Darkzveller/ProgrammeGyropodeV2/Kicad Defi/LibMiniL298N/3D/DC Motor Driver.jpg

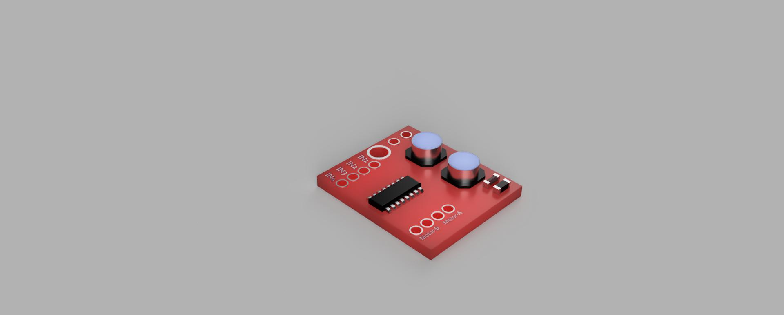
Kicad Defi/LibMiniL298N/3D/DC Motor Driver.jpg
