Darkzveller/ProgrammeGyropodeV2/Kicad Defi/LibGamelGe2_v6/3D/C_Rect_L4.0mm_W2.5mm_P2.50mm.STEP

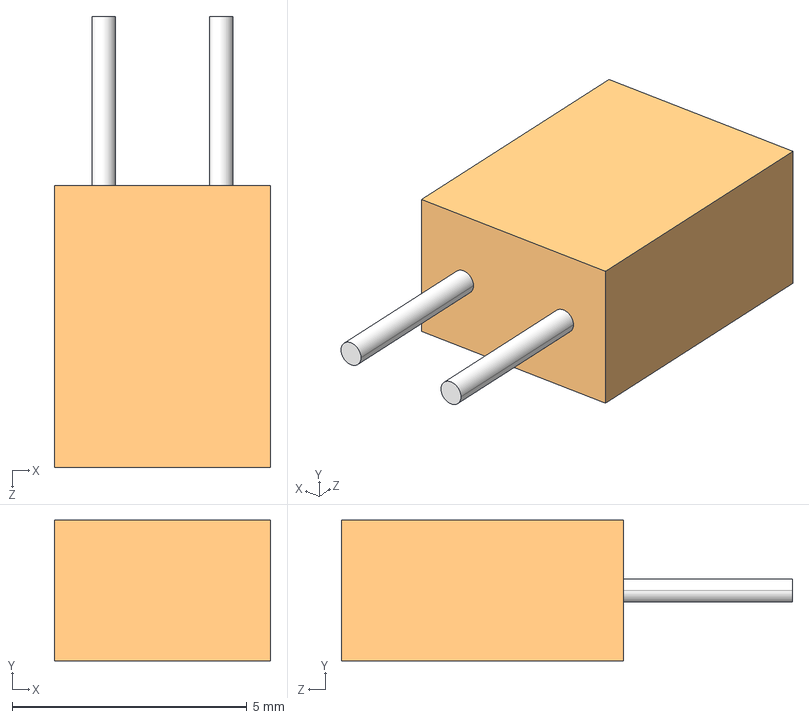
[picture p24: CAD file, 2024-11-21]
Kicad Defi/LibGamelGe2_v6/3D/C_Rect_L4.0mm_W2.5mm_P2.50mm.STEP
4.60 x 3.00 x 9.60 mm
