Darkzveller/ProgrammeGyropodeV2/Kicad Defi/LibMecatro/mecatro.models/L 1415465C.STEP

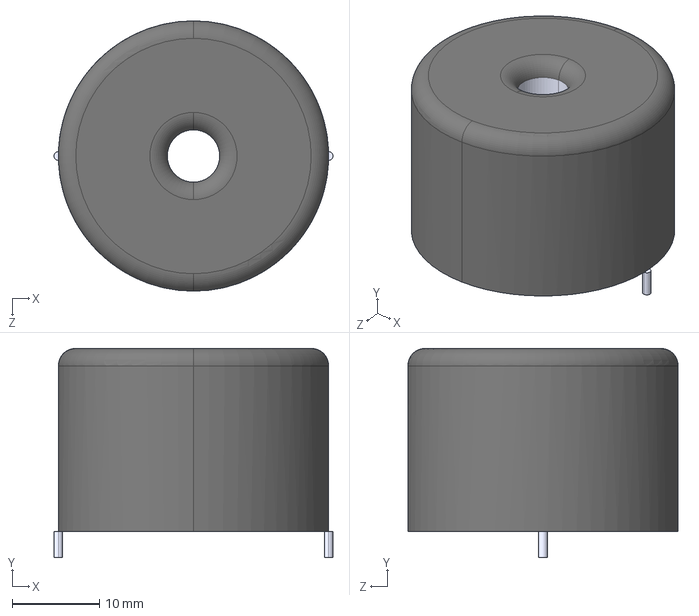
[picture p25: CAD file, 2024-11-21]
Kicad Defi/LibMecatro/mecatro.models/L 1415465C.STEP
32.0 x 24.0 x 31.0 mm
