Darkzveller/ProgrammeGyropodeV2/Kicad Defi/LibMiniL298N/3D/L298Mini.STEP

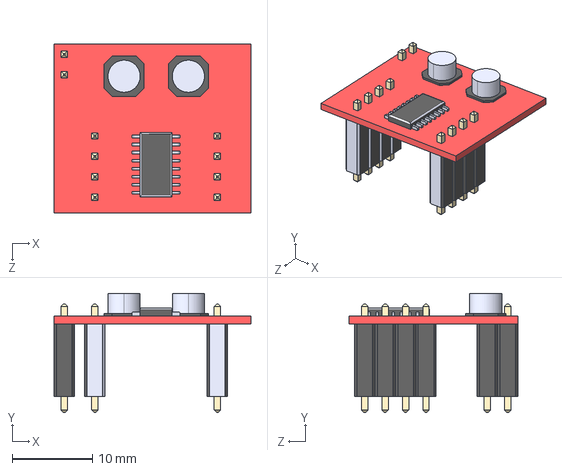
[picture p26: CAD file, 2024-11-21]
Kicad Defi/LibMiniL298N/3D/L298Mini.STEP
24.5 x 14.8 x 21.0 mm
