Darkzveller/ProgrammeGyropodeV2/Kicad Defi/LibRelais/LibRelais.3D/HF3FA.STEP

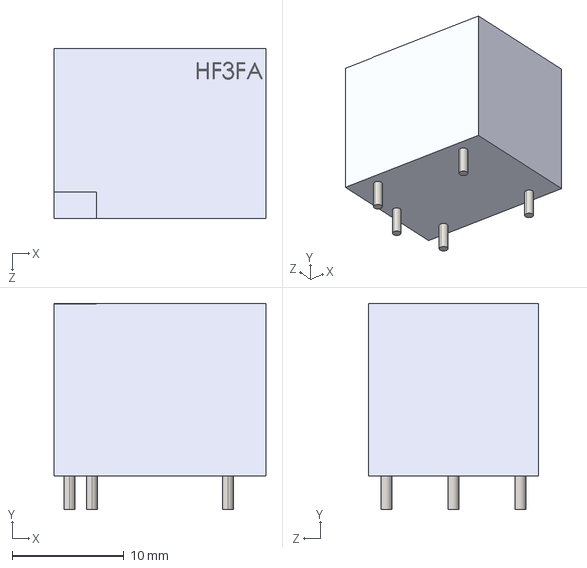
[picture p27: CAD file, 2024-11-21]
Kicad Defi/LibRelais/LibRelais.3D/HF3FA.STEP
19.0 x 18.5 x 15.2 mm
