Darkzveller/ProgrammeGyropodeV2/Kicad Defi/LibGamelGe2_v6/3D/autocom5.STEP

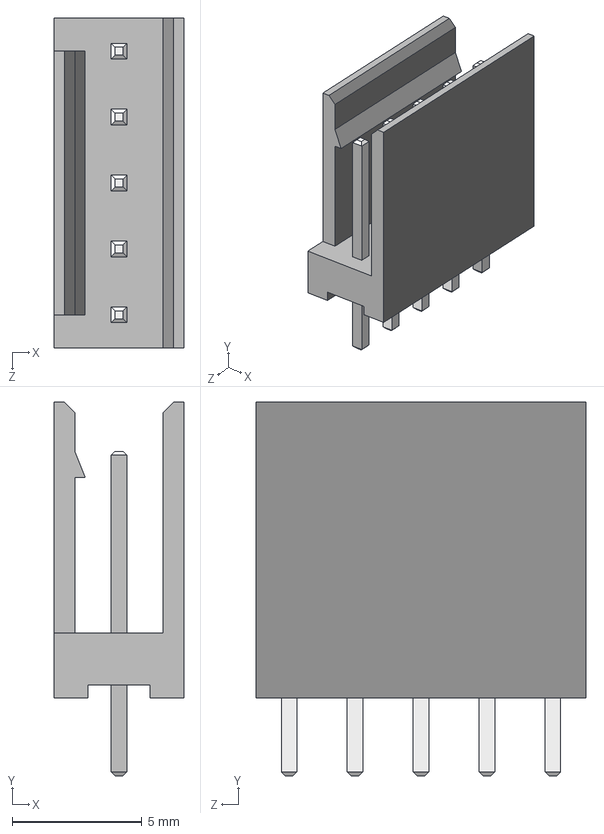
[picture p28: CAD file, 2024-11-21]
Kicad Defi/LibGamelGe2_v6/3D/autocom5.STEP
5.00 x 14.4 x 12.7 mm
