Darkzveller/ProgrammeGyropodeV2/Kicad Defi/LibMecatro/mecatro.models/MoteurGB37.STEP

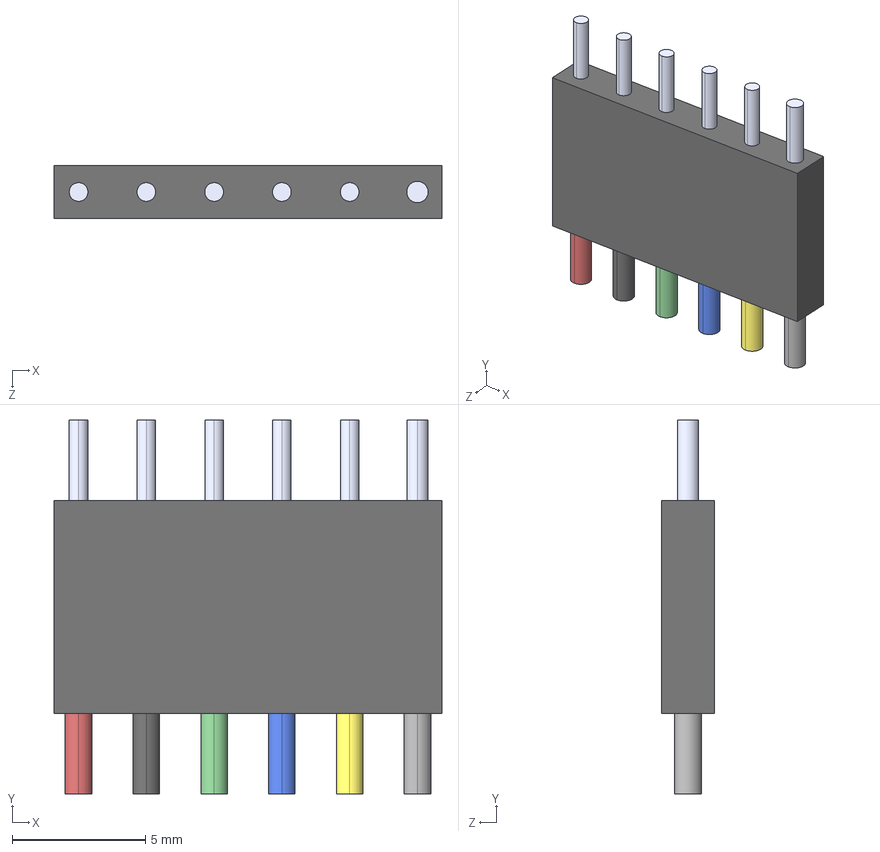
[picture p29: CAD file, 2024-11-21]
Kicad Defi/LibMecatro/mecatro.models/MoteurGB37.STEP
14.5 x 14.0 x 2.00 mm
