Darkzveller/ProgrammeGyropodeV2/Kicad Defi/LibMiniL298N/3D/DC Motor Driver .step

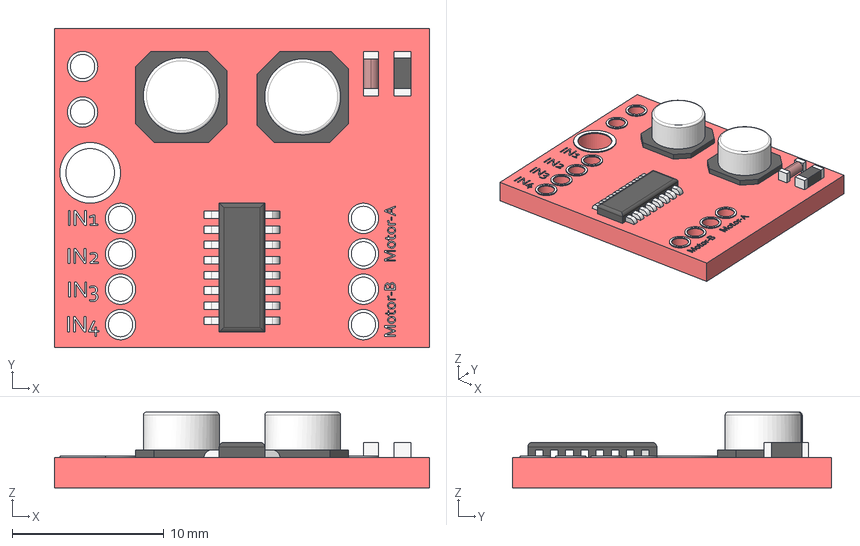
[picture p30: CAD file, 2024-11-21]
Kicad Defi/LibMiniL298N/3D/DC Motor Driver .step
24.7 x 21.0 x 5.00 mm
