Darkzveller/ProgrammeGyropodeV2/Kicad Defi/LibGamelGe2_v6/3D/C_Rect_L28.0mm_W8.0mm_P22.50mm.STEP

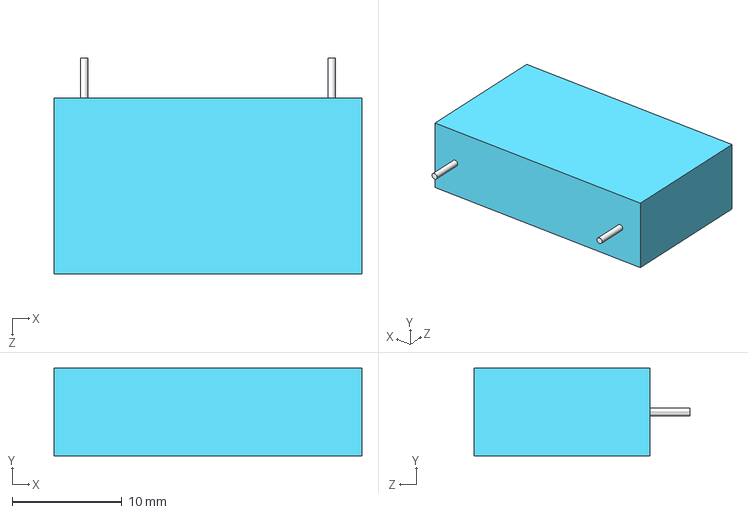
[picture p31: CAD file, 2024-11-21]
Kicad Defi/LibGamelGe2_v6/3D/C_Rect_L28.0mm_W8.0mm_P22.50mm.STEP
28.0 x 8.00 x 19.6 mm
