Darkzveller/ProgrammeGyropodeV2/Kicad Defi/LibMecatro/mecatro.models/DIP8-DEFAULT.STEP

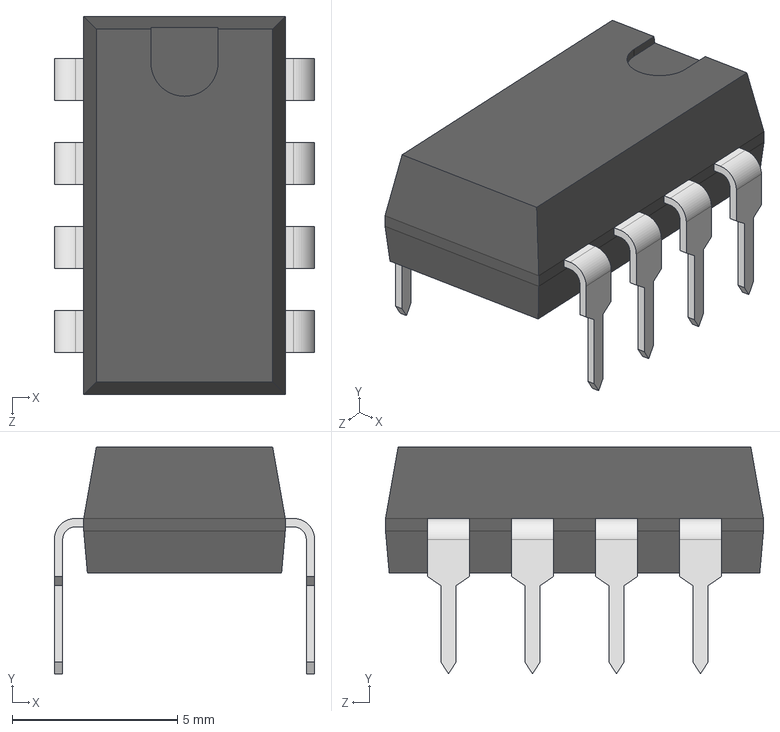
[picture p32: CAD file, 2024-11-21]
Kicad Defi/LibMecatro/mecatro.models/DIP8-DEFAULT.STEP
7.87 x 6.86 x 11.4 mm
