Darkzveller/ProgrammeGyropodeV2/Kicad Defi/LibGamelGe2_v6/3D/LED3mm_green.STEP

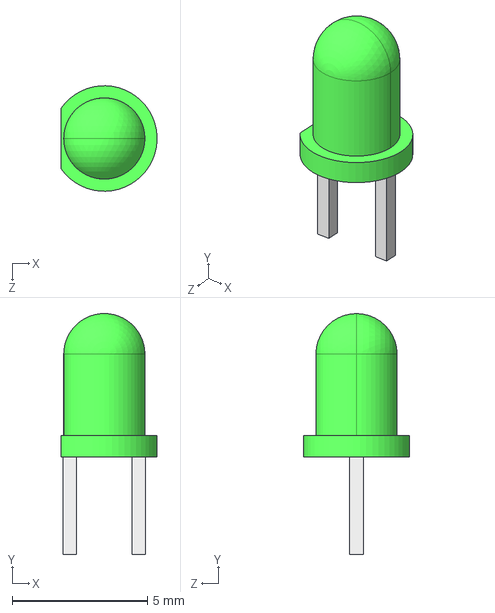
[picture p33: CAD file, 2024-11-21]
Kicad Defi/LibGamelGe2_v6/3D/LED3mm_green.STEP
3.55 x 8.90 x 3.90 mm
