Darkzveller/ProgrammeGyropodeV2/Kicad Defi/LibMecatro/mecatro.models/TO220-7-1.STEP

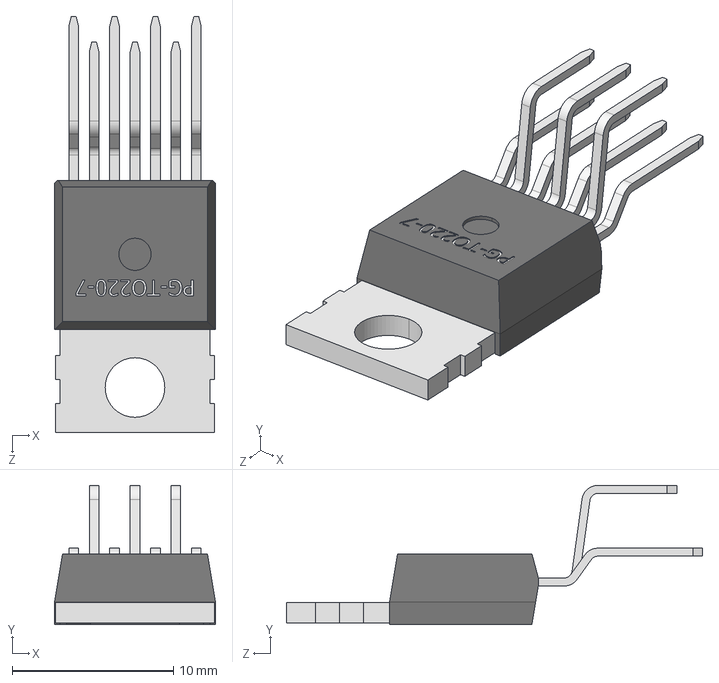
[picture p34: CAD file, 2024-11-21]
Kicad Defi/LibMecatro/mecatro.models/TO220-7-1.STEP
10.0 x 8.65 x 25.9 mm
