Darkzveller/ProgrammeGyropodeV2/Kicad Defi/LibGamelGe2_v6/3D/SW_push_5mm_blue.STEP

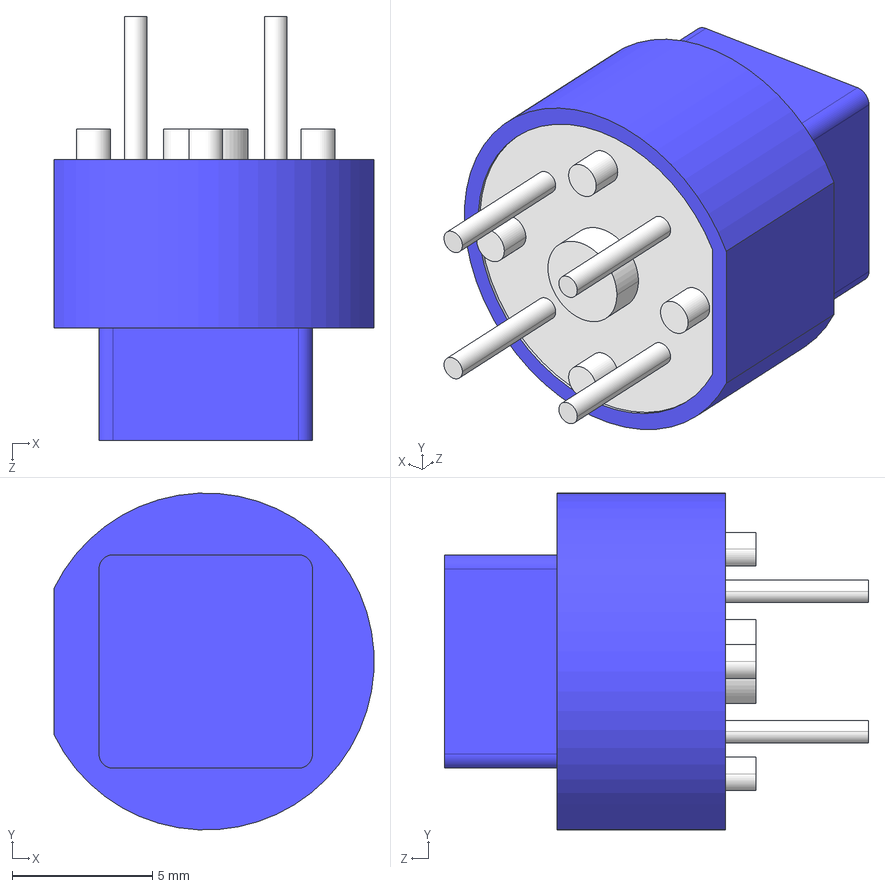
[picture p35: CAD file, 2024-11-21]
Kicad Defi/LibGamelGe2_v6/3D/SW_push_5mm_blue.STEP
11.4 x 12.0 x 15.1 mm
