Darkzveller/ProgrammeGyropodeV2/Kicad Defi/LibMecatro/mecatro.models/HC-05.STEP

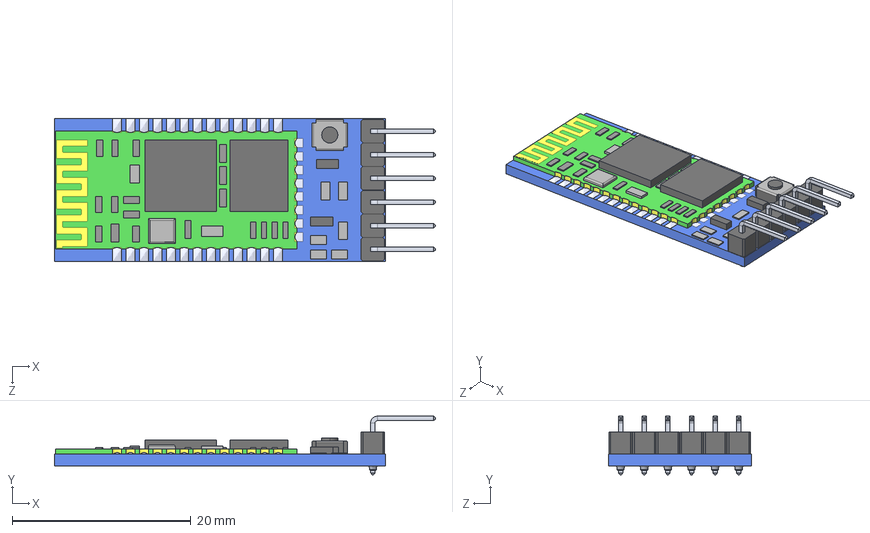
[picture p36: CAD file, 2024-11-21]
Kicad Defi/LibMecatro/mecatro.models/HC-05.STEP
42.6 x 6.55 x 16.0 mm
