Darkzveller/ProgrammeGyropodeV2/Kicad Defi/LibGamelGe2_v6/3D/HE10_2x10.STEP

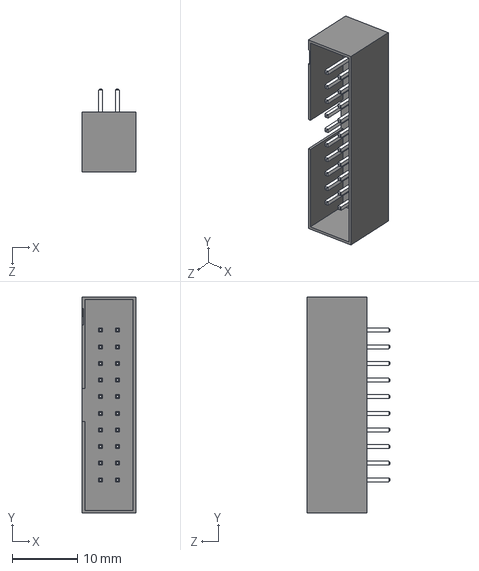
[picture p37: CAD file, 2024-11-21]
Kicad Defi/LibGamelGe2_v6/3D/HE10_2x10.STEP
8.20 x 33.0 x 12.7 mm
