Darkzveller/ProgrammeGyropodeV2/Kicad Defi/LibMecatro/mecatro.models/mpu6050schem.stp

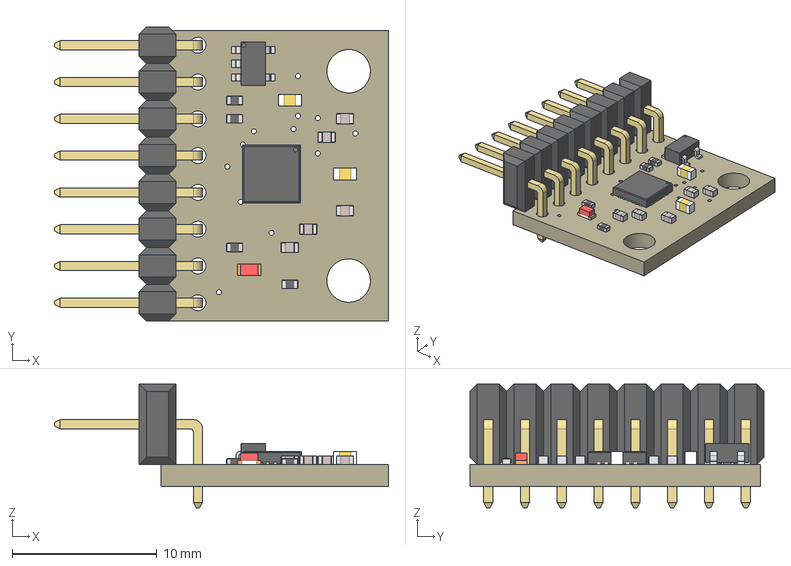
[picture p38: CAD file, 2024-11-21]
Kicad Defi/LibMecatro/mecatro.models/mpu6050schem.stp
23.1 x 20.3 x 8.56 mm
Board
SOT95P295X145-5N
QFN50P395X395X90-25T265X255N
CHIP-LED0603
HDRRA8W64P254_1X8_2032X254X556B
C0402 x 5
C0603 x 2
R0402 x 4
