Darkzveller/ProgrammeGyropodeV2/Kicad Defi/LibGamelGe2_v6/3D/C_Rect_L19.0mm_W5.0mm_P15.00mm.STEP

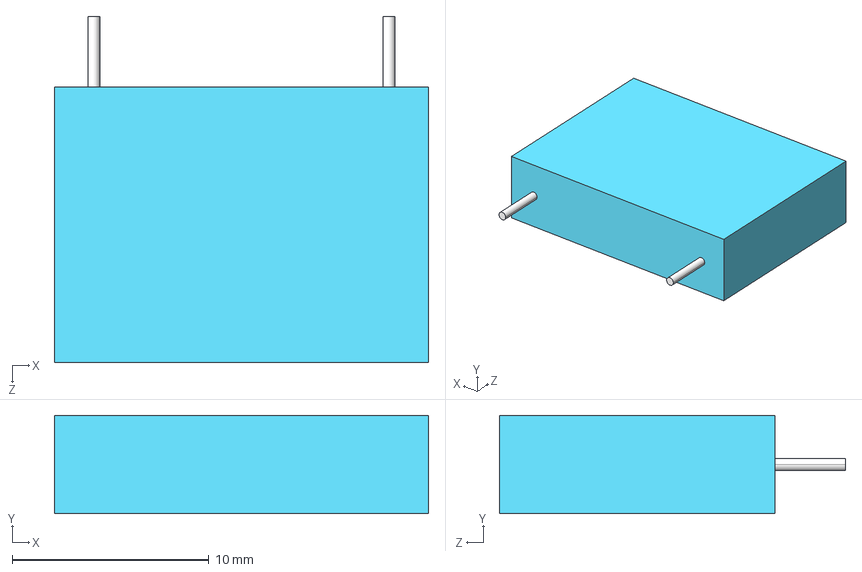
[picture p39: CAD file, 2024-11-21]
Kicad Defi/LibGamelGe2_v6/3D/C_Rect_L19.0mm_W5.0mm_P15.00mm.STEP
19.0 x 5.00 x 17.6 mm
