Darkzveller/ProgrammeGyropodeV2/Kicad Defi/LibMecatro/mecatro.models/esp32-DEV.STEP

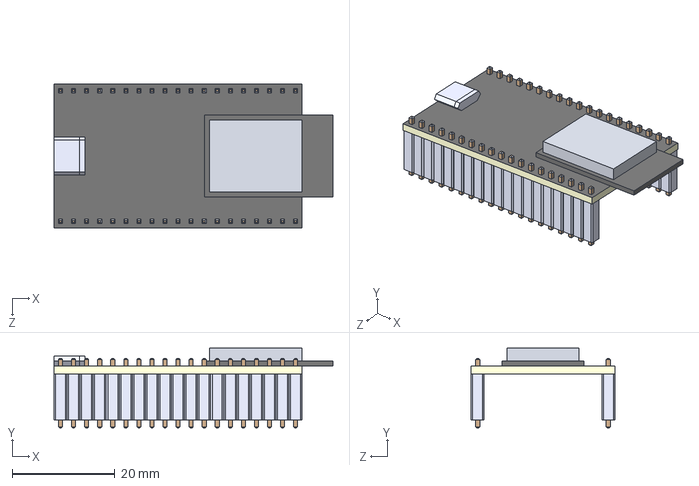
[picture p40: CAD file, 2024-11-21]
Kicad Defi/LibMecatro/mecatro.models/esp32-DEV.STEP
54.3 x 15.5 x 27.9 mm
