Darkzveller/ProgrammeGyropodeV2/Kicad Defi/LibGamelGe2_v6/3D/cny70.STEP

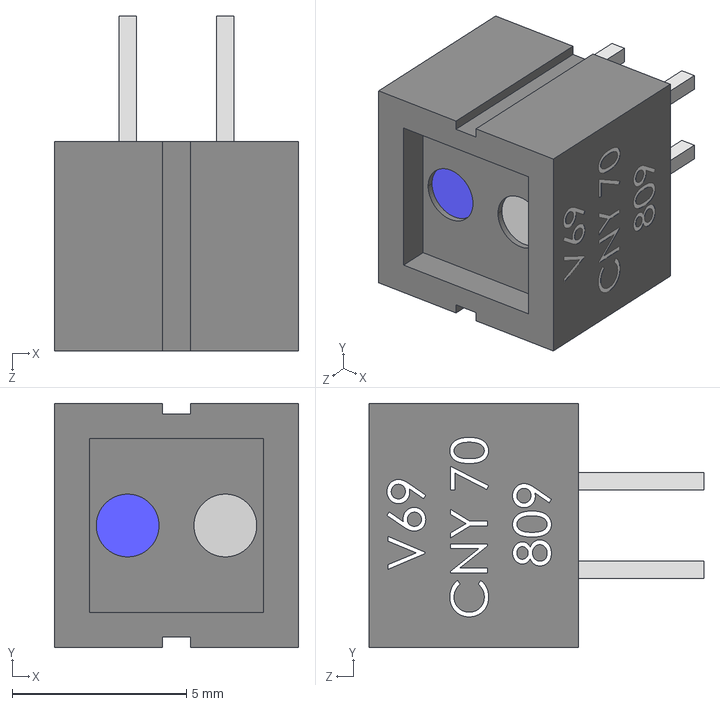
[picture p41: CAD file, 2024-11-21]
Kicad Defi/LibGamelGe2_v6/3D/cny70.STEP
7.00 x 7.00 x 9.60 mm
