Darkzveller/ProgrammeGyropodeV2/Kicad Defi/LibGamelGe2_v6/3D/OmnimateSL_1x04.STEP

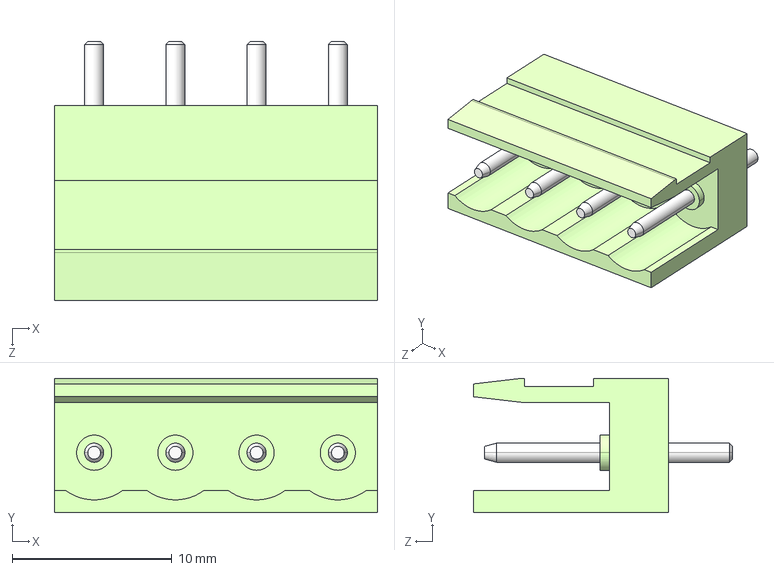
[picture p42: CAD file, 2024-11-21]
Kicad Defi/LibGamelGe2_v6/3D/OmnimateSL_1x04.STEP
20.2 x 8.40 x 16.2 mm
