Darkzveller/ProgrammeGyropodeV2/Kicad Defi/LibGamelGe2_v6/3D/Potentiometer_Horizontal.STEP

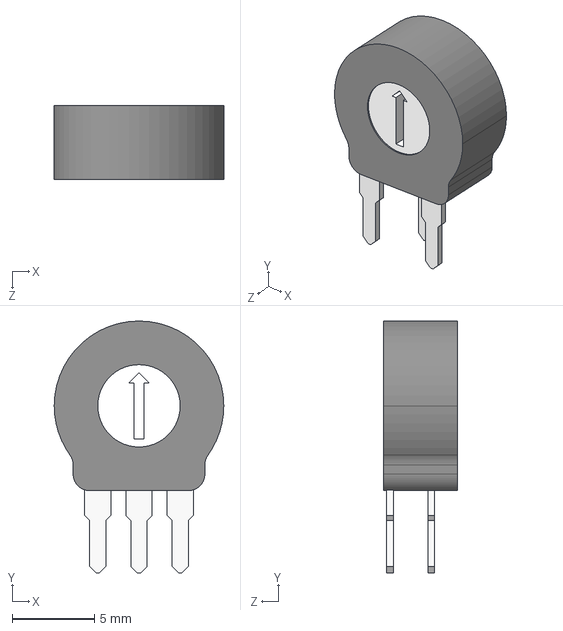
[picture p43: CAD file, 2024-11-21]
Kicad Defi/LibGamelGe2_v6/3D/Potentiometer_Horizontal.STEP
10.3 x 15.3 x 4.50 mm
