Darkzveller/ProgrammeGyropodeV2/Kicad Defi/LibGamelGe2_v6/3D/OmnimateSL_1x02.STEP

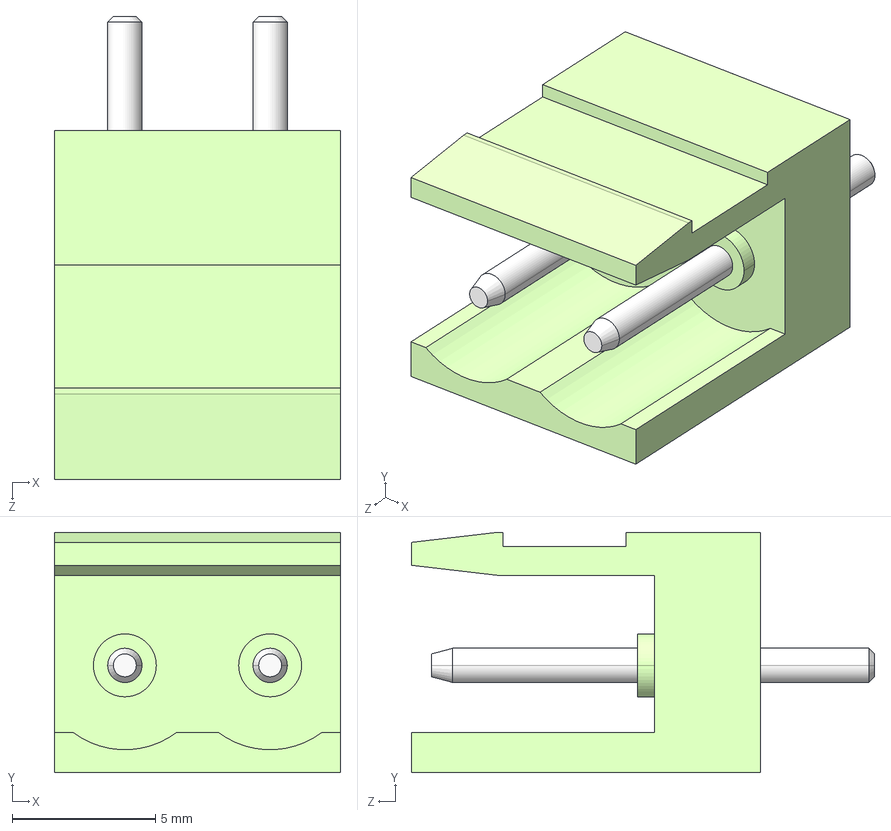
[picture p44: CAD file, 2024-11-21]
Kicad Defi/LibGamelGe2_v6/3D/OmnimateSL_1x02.STEP
10.0 x 8.40 x 16.2 mm
