Darkzveller/ProgrammeGyropodeV2/Kicad Defi/LibGamelGe2_v6/3D/TO220_vertical.STEP

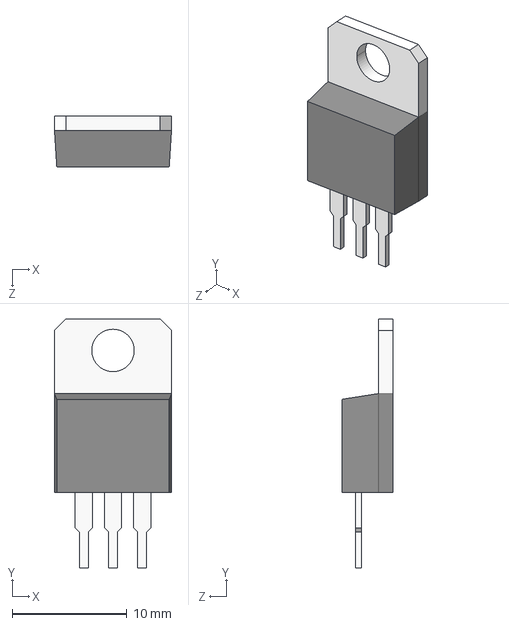
[picture p45: CAD file, 2024-11-21]
Kicad Defi/LibGamelGe2_v6/3D/TO220_vertical.STEP
10.2 x 21.7 x 4.46 mm
