Darkzveller/ProgrammeGyropodeV2/Kicad Defi/LibGamelGe2_v6/3D/LED5mm_orange.STEP

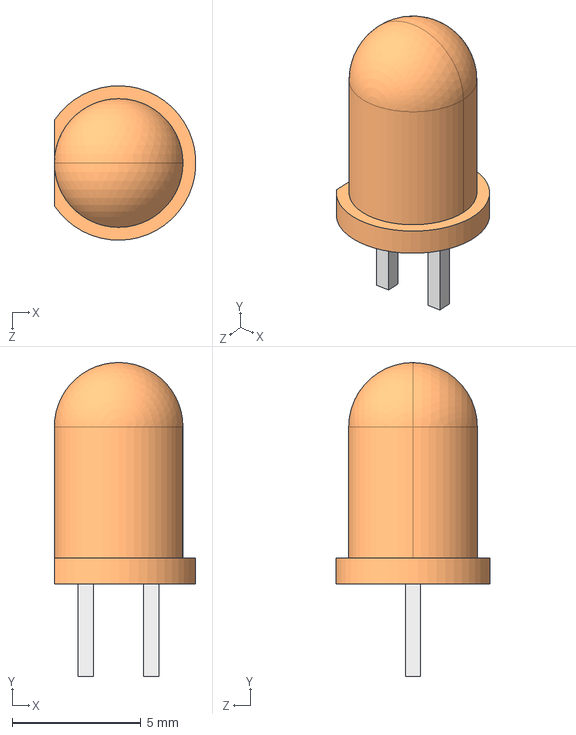
[picture p46: CAD file, 2024-11-21]
Kicad Defi/LibGamelGe2_v6/3D/LED5mm_orange.STEP
5.49 x 12.2 x 6.00 mm
