Darkzveller/ProgrammeGyropodeV2/Kicad Defi/LibGamelGe2_v6/3D/DO35_7.62mm.STEP

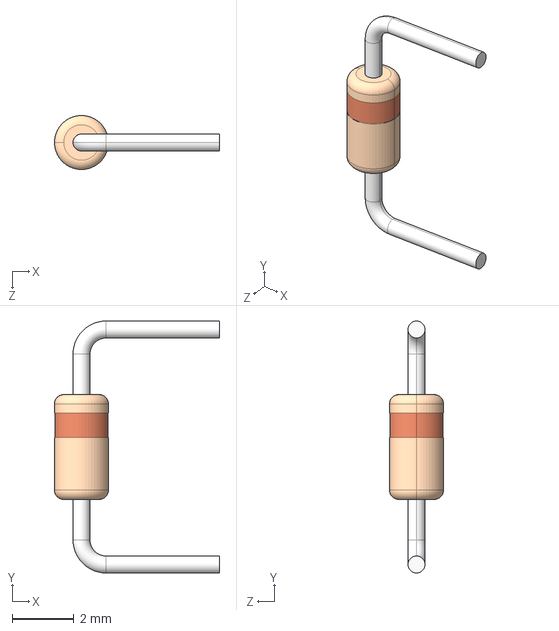
[picture p47: CAD file, 2024-11-21]
Kicad Defi/LibGamelGe2_v6/3D/DO35_7.62mm.STEP
5.35 x 8.17 x 1.75 mm
