Darkzveller/ProgrammeGyropodeV2/Kicad Defi/LibGamelGe2_v6/3D/HE10_2x8.STEP

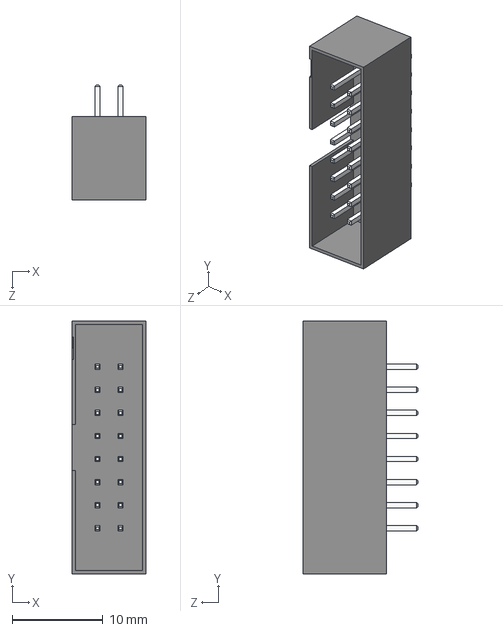
[picture p48: CAD file, 2024-11-21]
Kicad Defi/LibGamelGe2_v6/3D/HE10_2x8.STEP
8.20 x 27.9 x 12.7 mm
