Darkzveller/ProgrammeGyropodeV2/Kicad Defi/LibGamelGe2_v6/3D/C_Rect_L7.0mm_W2.5mm_P5.00mm.STEP

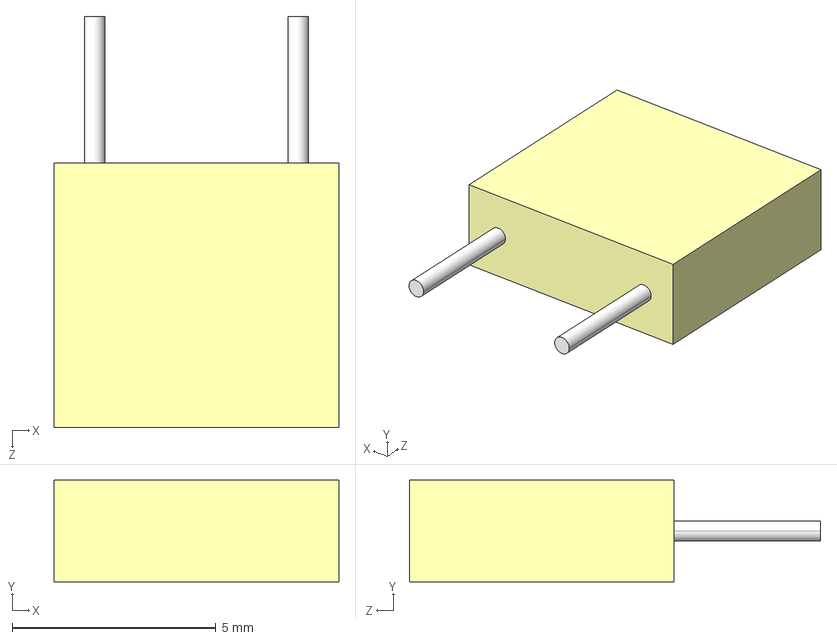
[picture p49: CAD file, 2024-11-21]
Kicad Defi/LibGamelGe2_v6/3D/C_Rect_L7.0mm_W2.5mm_P5.00mm.STEP
7.00 x 2.50 x 10.1 mm
