Darkzveller/ProgrammeGyropodeV2/Kicad Defi/LibGamelGe2_v6/3D/autocom4.STEP

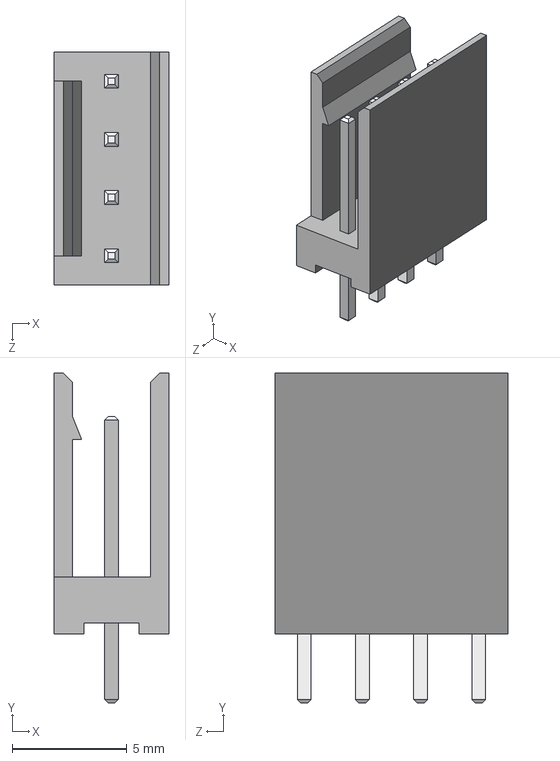
[picture p50: CAD file, 2024-11-21]
Kicad Defi/LibGamelGe2_v6/3D/autocom4.STEP
5.00 x 14.4 x 10.2 mm
