Darkzveller/ProgrammeGyropodeV2/Kicad Defi/LibGamelGe2_v6/3D/R_Axial_L6.3mm_D2.5mm_P10.16mm_Horizontal.STEP

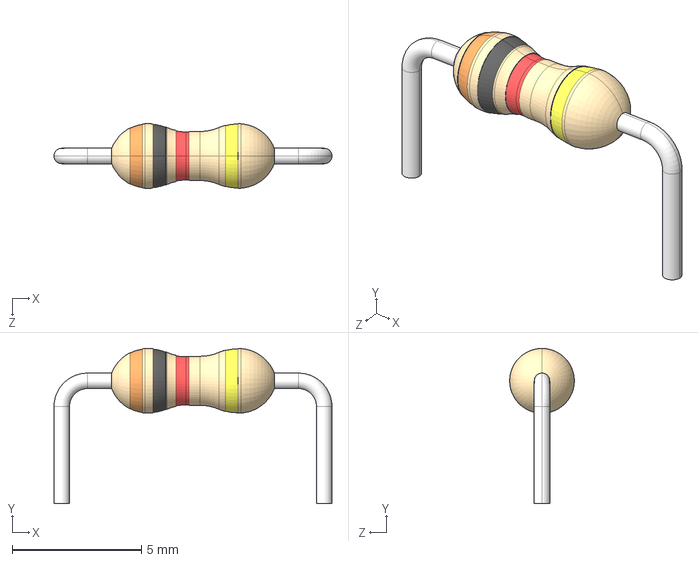
[picture p51: CAD file, 2024-11-21]
Kicad Defi/LibGamelGe2_v6/3D/R_Axial_L6.3mm_D2.5mm_P10.16mm_Horizontal.STEP
10.8 x 6.00 x 2.51 mm
