Darkzveller/ProgrammeGyropodeV2/Kicad Defi/LibGamelGe2_v6/3D/C_Rect_L13.0mm_W5.0mm_P10.00mm.STEP

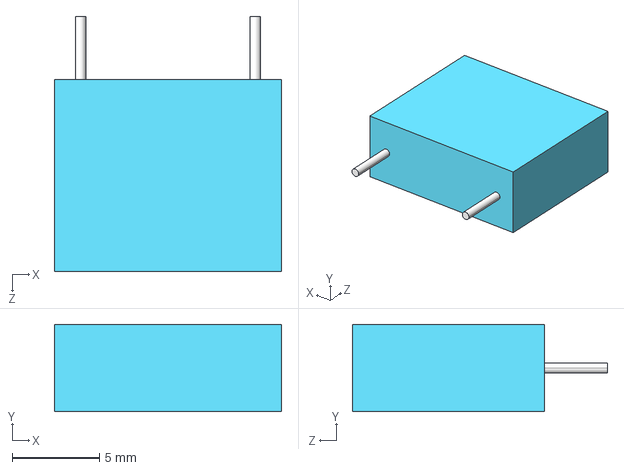
[picture p52: CAD file, 2024-11-21]
Kicad Defi/LibGamelGe2_v6/3D/C_Rect_L13.0mm_W5.0mm_P10.00mm.STEP
13.0 x 5.00 x 14.6 mm
