Darkzveller/ProgrammeGyropodeV2/Kicad Defi/LibGamelGe2_v6/3D/C_Rect_L10.0mm_W3.0mm_P7.50mm.STEP

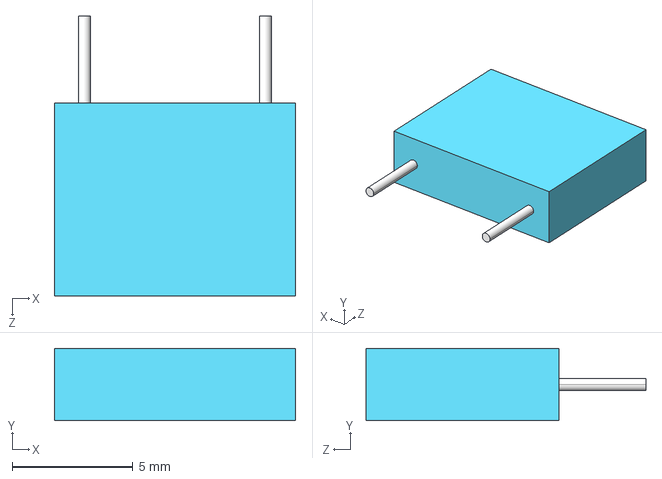
[picture p53: CAD file, 2024-11-21]
Kicad Defi/LibGamelGe2_v6/3D/C_Rect_L10.0mm_W3.0mm_P7.50mm.STEP
10.0 x 3.00 x 11.6 mm
