Darkzveller/ProgrammeGyropodeV2/Kicad Defi/LibGamelGe2_v6/3D/autocom3.STEP

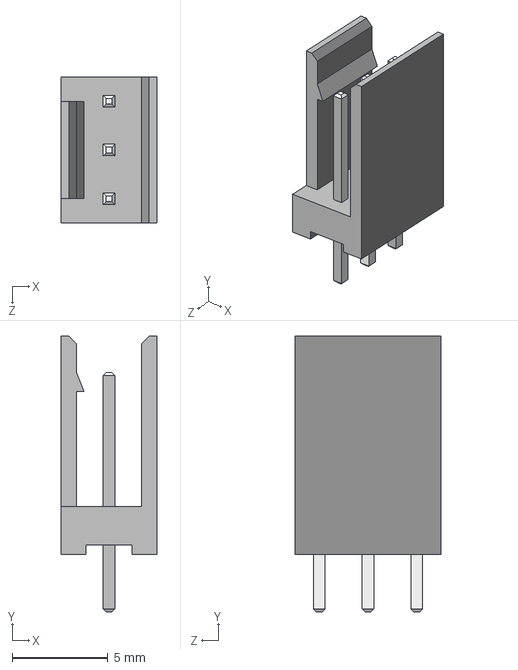
[picture p54: CAD file, 2024-11-21]
Kicad Defi/LibGamelGe2_v6/3D/autocom3.STEP
5.00 x 14.4 x 7.62 mm
