Darkzveller/ProgrammeGyropodeV2/Kicad Defi/LibGamelGe2_v6/3D/HE10_2x5.STEP

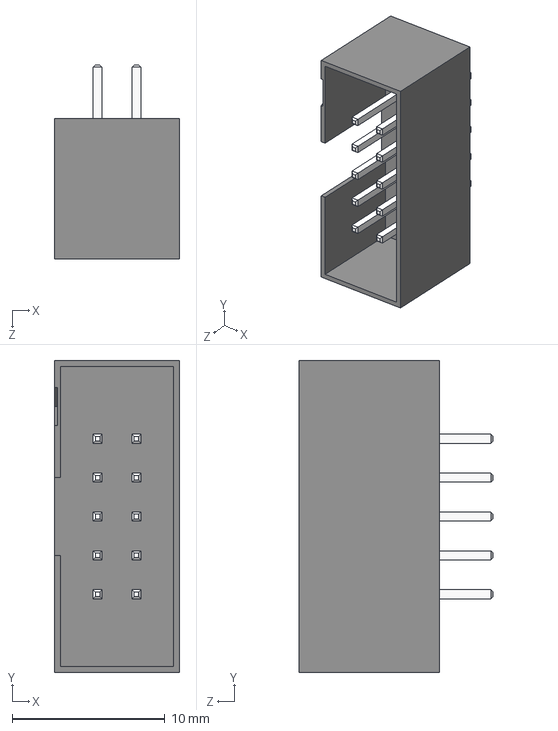
[picture p55: CAD file, 2024-11-21]
Kicad Defi/LibGamelGe2_v6/3D/HE10_2x5.STEP
8.20 x 20.4 x 12.7 mm
