Darkzveller/ProgrammeGyropodeV2/Kicad Defi/LibGamelGe2_v6/3D/Potentiometer_Vertical.STEP

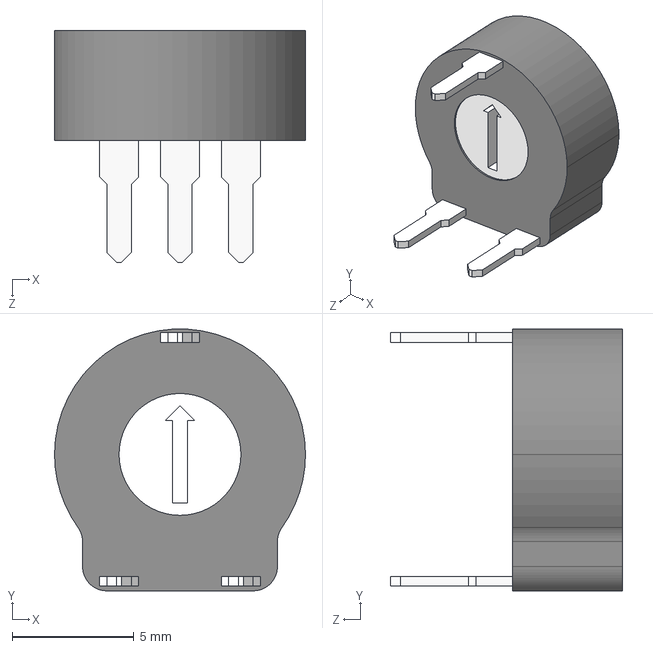
[picture p56: CAD file, 2024-11-21]
Kicad Defi/LibGamelGe2_v6/3D/Potentiometer_Vertical.STEP
10.3 x 10.7 x 9.50 mm
