Darkzveller/ProgrammeGyropodeV2/Kicad Defi/LibGamelGe2_v6/3D/TO220_horizontal.STEP

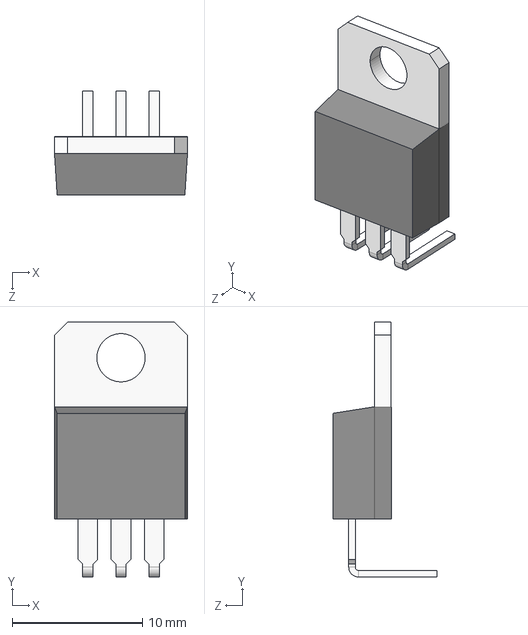
[picture p57: CAD file, 2024-11-21]
Kicad Defi/LibGamelGe2_v6/3D/TO220_horizontal.STEP
10.2 x 19.6 x 7.96 mm
