Darkzveller/ProgrammeGyropodeV2/Kicad Defi/LibGamelGe2_v6/3D/autocom2.STEP

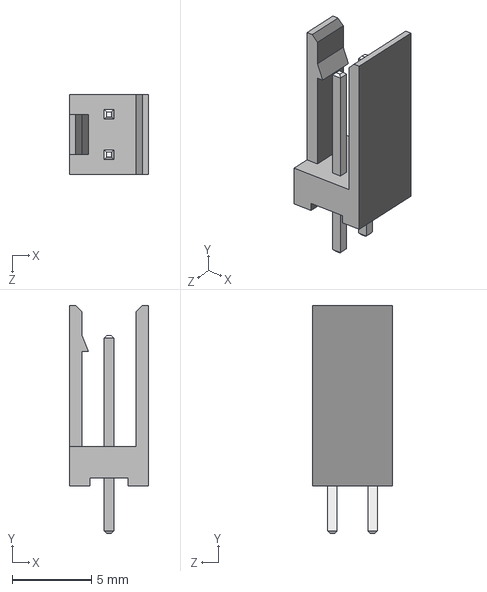
[picture p58: CAD file, 2024-11-21]
Kicad Defi/LibGamelGe2_v6/3D/autocom2.STEP
5.00 x 14.4 x 5.08 mm
