Darkzveller/ProgrammeGyropodeV2/Kicad Defi/LibGamelGe2_v6/3D/BNC.STEP

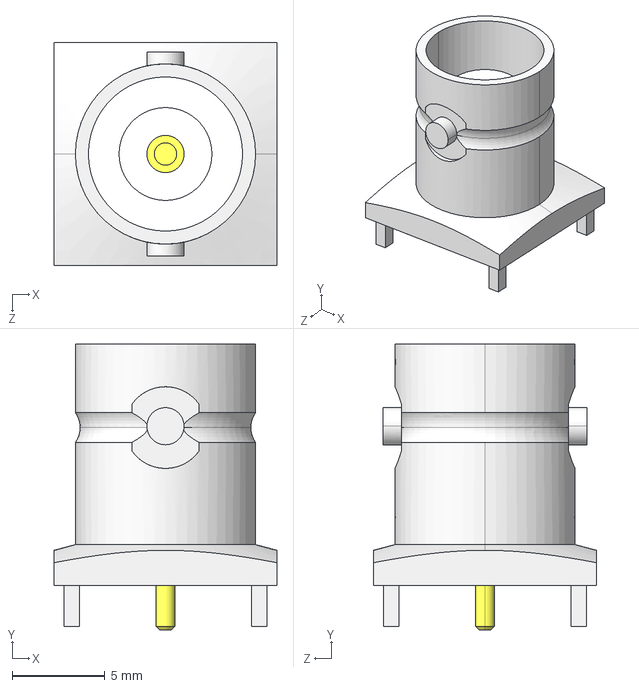
[picture p59: CAD file, 2024-11-21]
Kicad Defi/LibGamelGe2_v6/3D/BNC.STEP
12.0 x 15.4 x 12.0 mm
