Darkzveller/ProgrammeGyropodeV2/Kicad Defi/Defi.kicad_pcb

## KiCad design Kicad Defi/Defi.kicad_pcb (2025-05-09)

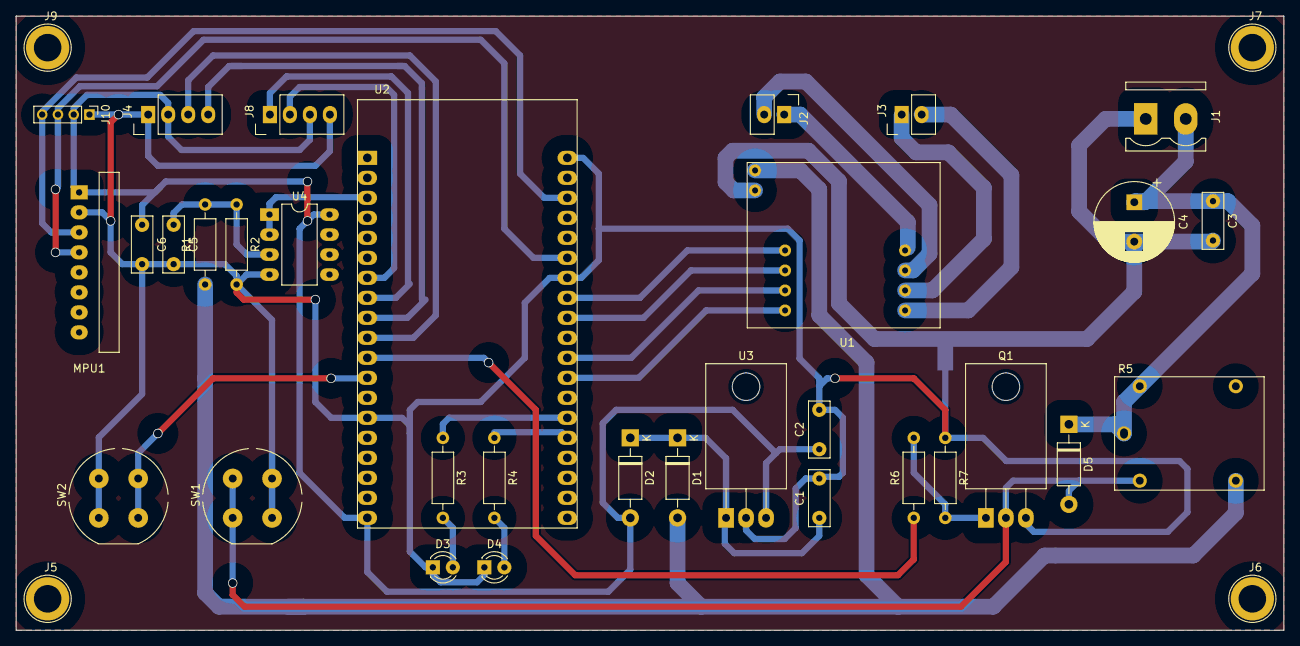
[picture p60: board Defi.kicad_pcb from above]

Board: 2 copper layers, 161.0 x 78.0 mm, 37 parts (1 on the bottom side), 30 nets.

Parts:
C1, C3, C5, C6: 100n; C_Rect_L7.0mm_W2.5mm_P5.00mm
C2: 330n; C_Rect_L7.0mm_W2.5mm_P5.00mm
C4: 100µ; CP_Radial_D10.0mm_P5.00mm
D1, D2, D5: 1N400X; D_DO-41_SOD81_P10.16mm_Horizontal
D3, D4: LED3mm_orange; LED_D3.0mm_orange
J1: Omnimate2; OmnimateSL-5,08_1x02_P5.08mm_Vertical
J2, J3: Autocom2
J4, J8: Autocom4
J5, J6, J7, J9: Mounting_Screw_3mm
J10: Autocom4; PinHeader_1x04_P2.00mm_Vertical
MPU1: MPU6050
NT4: NetTie_2; NetTie-2_SMD_Pad2.0mm
Q1: IRL510; TO-220-3_Horizontal_TabDown
R1: 15k; R_Axial_DIN0207_L6.3mm_D2.5mm_P10.16mm_Horizontal
R2: 5600; R_Axial_DIN0207_L6.3mm_D2.5mm_P10.16mm_Horizontal
R3, R4: 480; R_Axial_DIN0207_L6.3mm_D2.5mm_P10.16mm_Horizontal
R5: HF3FA
R6: 100; R_Axial_DIN0207_L6.3mm_D2.5mm_P10.16mm_Horizontal
R7: 10k; R_Axial_DIN0207_L6.3mm_D2.5mm_P10.16mm_Horizontal
SW1, SW2: SW_Push_blue; SW_PUSH_5mm_blue
U1: Mini_L298N
U2: ESP32-DEVKITC-32D; MODULE_ESP32-DEVKITC-32D
U3: LM7805_TO220; TO-220-3_Horizontal_TabDown
U4: TL082; DIP-8_W7.62mm_LongPads

Connections:
+5V: C2.1, C6.1, D2.2 (A), J4.2, J8.3, J10.2, MPU1.1 (VCC), U2.19 (EXT_5V), U3.3 (VO), U4.8 (V+)
+12P: D1.2 (A), R1.1, R5.4 (NO), U1.1 (VDD)
+12V: C3.1, C4.1, D5.1 (K), J1.2, R5.1 (C), R5.3 (Com)
Bouton Reset: SW2.2, U2.12 (IO14)
EncodeurA: J8.2, U2.7 (IO32)
EncodeurB: J8.1, U2.8 (IO33)
EncodeurC: J4.4, U2.9 (IO25)
EncodeurD: J4.3, U2.10 (IO26)
GND: C1.2, C2.2, C5.2, C6.2, D3.1 (K), D4.1 (K), J4.1, J8.4, J10.1, MPU1.2 (GND), NT4.2, Q1.3 (S), R2.2, R7.1, SW1.2, SW2.1, U2.14 (GND1), U2.20 (GND3), U2.26 (GND2), U3.2 (GND), U4.4 (V-)
GNDPWR: C3.2, C4.2, J1.1, NT4.1, U1.2 (GND)
Led1: R3.1, U2.33 (IO0)
Led2: R4.1, U2.34 (IO2)
Moteur A: J2.1, U1.7 (Out1_Moteur_A)
Moteur B: J2.2, U1.8 (Out2_Moteur_A)
Moteur C: J3.1, U1.9 (Out1_Moteur_B)
Moteur D: J3.2, U1.10 (Out2_Moteur_B)
unnamed: C1.1, D1.1 (K), D2.1 (K), U3.1 (VI)
unnamed: D3.2 (A), R3.2
unnamed: D4.2 (A), R4.2
unnamed: D5.2 (A), Q1.2 (D), R5.2 (C), SW1.1
unnamed: Q1.1 (G), R6.2, R7.2
unnamed: C5.1, R1.2, R2.1, U4.3 (+)
PWM_1: U1.6 (IN4), U2.31 (IO16)
PWM_2: U1.5 (IN3), U2.30 (IO17)
PWM_3: U1.4 (IN2), U2.28 (IO18)
PWM_4: U1.3 (IN1), U2.27 (IO19)
SCL: J10.4, MPU1.3 (SCL), U2.22 (IO22)
SDA: J10.3, MPU1.4 (SDA), U2.25 (IO21)
Signal de commande: R6.1, U2.11 (IO27)
Tension: U2.3 (SENSOR_VP), U4.1, U4.2 (-)
