Darkzveller/ProgrammeGyropodeV2/(commit log)

2024-11-21 premier commit
    [110990030.step, BNC.SLDPRT, BNC.STEP, C_Rect_L10.0mm_W3.0mm_P7.50mm.SLDPRT, C_Rect_L10.0mm_W3.0mm_P7.50mm.STEP, C_Rect_L13.0mm_W5.0mm_P10.00mm.SLDPRT, C_Rect_L13.0mm_W5.0mm_P10.00mm.STEP, C_Rect_L19.0mm_W5.0mm_P15.00mm.SLDPRT]
2024-11-21 Mutex + LCD+ENCODEUR+MPU = test validé
    [Defi.kicad_pcb, Defi.kicad_sch]
2024-11-21 Mise en place de la tache + LED + DEF SCAN I2C ID + AFFICHAGE INIT + Commentaire précédent test toujours présent
2025-05-09 Je sais plus ce que j'ai fait mais j'envoie au cas ou
    [Defi.kicad_pcb]
2025-11-21 Ajout pin moteur et fonctionnement moteur
2025-11-21 Ajout meusre tension fonctionnelle
    [Linéarisation batterie.xlsx]
2025-11-21 Ajout interrupteur batterie + ajout kp kd Ki en position et premier réglages des coeffs
2025-11-21 Ajout de toute la partie asservissement vitesse + il faut redéterminer les différents coefficient permettant au robot de pouvoir s'asservir + ajout de la config terminal mecatro + ajout code joshua
